Tora0615/WildlifeObservationDevice/feature tests/testModules/INMP_with_SD_with_custom_library_clean/INMP_with_SD_with_custom_library_clean.ino

// SD
#include <SPI.h>
#include "SdFat.h"
#include "sdios.h"
#define SPI_SPEED SD_SCK_MHZ(15)
#define CHIP_SELECT 5

// SD_FAT_TYPE 3 (FAT16/FAT32 and exFAT)
SdFs sd;


void SDInit(){
  if (!sd.begin(CHIP_SELECT, SPI_SPEED)) {
    Serial.println("SD card init error");
    while(1){
      delay(1000);
    }
  }
}



// void recordAndWrite(char* filename, int recordSeconds, int SAMPLE_RATE, int DATA_BIT, CHANNEL_STEREO){




// }



#include "MEMS_INMP441.h"

// #define SAMPLE_RATE     (38000)
// #define DATA_BIT        (16)

// Left : 0 / Right : 1 / stereo : 2
#define CHANNEL_LEFT     (0)
#define CHANNEL_RIGHT    (1)
#define CHANNEL_STEREO   (2)

INMP441 microphone(I2S_SCK_IO, I2S_WS_IO, I2S_DI_IO);
bool isRecording = false;



#define RECORD_TIME_DEBUG
// #define PERCENTAGE_DEBUG
#define INMP_COMMON_DEBUG


// #ifdef RECORD_TIME_DEBUG
//   int duration = 0;
//   int I2s_duration = 0;
//   int writeFile_duration = 0;
//   unsigned long busyWait_duration = 0;
// #endif


void recordWithDualChannel(int recordSeconds, char *filenameWithPath, float gain_ratio){
  if(!isRecording){
    // flag switch
    isRecording = !isRecording; 

    /*--- setting part ---*/
    // record setting 
    const uint16_t SAMPLE_RATE = 38000;
    const uint8_t  DATA_BIT = 16;
    const uint8_t  CHANNEL = CHANNEL_STEREO;
    float volume_gain = 64 * gain_ratio;  // 32 ~ 128 best
    const int numOfData = 512; // size of each collection
    byte header[44];  
    byte dataBuffer[numOfData];
    // SD setting 
    FsFile soundFile;


    /*--- execute part ---*/
    // remove old file 
    if (sd.exists(filenameWithPath)){
      sd.remove(filenameWithPath);
    }
    // create a new file 
    if (!soundFile.open(filenameWithPath, O_WRONLY | O_CREAT )) {     // open need char array, not string. So use c_str to convert
      Serial.println(" --> open file failed");
    }

    while(microphone.begin(SAMPLE_RATE, DATA_BIT, CHANNEL) != 0){
      Serial.println(" I2S init failed");
    }
    Serial.println("I2S init success");
    microphone.createWavHeader(header, recordSeconds, SAMPLE_RATE, DATA_BIT, CHANNEL);
    soundFile.write(header, 44);



    Serial.println("start");
    #ifdef RECORD_TIME_DEBUG
      int duration = millis();
      int I2s_duration = 0;
      int writeFile_duration = 0;
      unsigned long busyWait_duration = 0;
    #endif
    #ifdef PERCENTAGE_DEBUG
      float tempJ = 0;
    #endif


    int wavDataSize = recordSeconds * microphone.bytePerSecond; 
    int loopCount = wavDataSize / numOfData;
    int busy_wait_fix_factor = 4;
    unsigned long intervalTotalLen = recordSeconds * 1000.0 * 1000.0 / loopCount;
    #ifdef RECORD_TIME_DEBUG
      Serial.print("interval of each task (sec) : ");
      Serial.println(intervalTotalLen/1000000.0, 8);
      Serial.println("loopCount : " + String(loopCount));
    #endif
    for (int j = 0; j < loopCount; ++j) {
      // print process percentage 
      #ifdef PERCENTAGE_DEBUG
        if( ((j - tempJ)/(loopCount))*100.0 > 5) {
          Serial.println( ((float)j/(loopCount)) *100 );
          tempJ = j;
        }
      #endif

      // for busy wait
      unsigned long busy_wait_intervalTimer = micros(); 

      // read a size
      #ifdef RECORD_TIME_DEBUG
        int tempreadtime = millis();
      #endif
      microphone.read(dataBuffer, numOfData);
      #ifdef RECORD_TIME_DEBUG
        I2s_duration += millis() - tempreadtime;
      #endif

      // clean noise of not use side
      // DualChannel no need

      // let it louder of this size
      microphone.louder(dataBuffer, numOfData, volume_gain);

      // write this size
      #ifdef RECORD_TIME_DEBUG
        int tempwritefiletime = millis();
      #endif
      soundFile.write((uint8_t*)dataBuffer, numOfData);
      #ifdef RECORD_TIME_DEBUG
        writeFile_duration += millis() - tempwritefiletime;
      #endif

      // busy wait
      #ifdef RECORD_TIME_DEBUG
        int busyWaitTime = micros();
      #endif
      while (micros() - busy_wait_intervalTimer < intervalTotalLen && j % busy_wait_fix_factor == 0) {}
      #ifdef RECORD_TIME_DEBUG
        busyWait_duration += micros() - busyWaitTime;
      #endif
    }
    soundFile.close();
    microphone.end();
    #ifdef INMP_COMMON_DEBUG
      Serial.println("finish");
    #endif

    #ifdef RECORD_TIME_DEBUG
      Serial.println("use time : " + String ((millis() - duration)/1000.0, 4));
      Serial.println("I2s_duration : " + String (I2s_duration/1000.0, 4));
      Serial.println("writeFile_duration : " + String (writeFile_duration/1000.0, 4));
      Serial.println("busyWait_duration : " + String (busyWait_duration/1000000.0, 4));
    #endif

    // flag switch
    isRecording = !isRecording; 
  }
}


void recordWithMonoChannel(int recordSeconds, char *filenameWithPath, float gain_ratio, uint8_t CHANNEL){
  if(!isRecording){
    // flag switch
    isRecording = !isRecording; 

    /*--- setting part ---*/
    const uint16_t SAMPLE_RATE = 44100;
    const uint8_t  DATA_BIT = 16;
    float volume_gain = 64 * gain_ratio;  // 32 ~ 128 best
    const int numOfData = 512; // size of each collection
    byte header[44];  
    byte dataBuffer[numOfData];
    // SD setting 
    FsFile soundFile;

    /*--- execute part ---*/
    // remove old file 
    if (sd.exists(filenameWithPath)){
      sd.remove(filenameWithPath);
    }
    // create a new file 
    if (!soundFile.open(filenameWithPath, O_WRONLY | O_CREAT )) {     // open need char array, not string. So use c_str to convert
      Serial.println(" --> open file failed");
    }

    while(microphone.begin(SAMPLE_RATE, DATA_BIT, CHANNEL) != 0){
      Serial.println(" I2S init failed");
    }
    Serial.println("I2S init success");
    microphone.createWavHeader(header, recordSeconds, SAMPLE_RATE, DATA_BIT, CHANNEL);
    soundFile.write(header, 44);



    Serial.println("start");
    #ifdef RECORD_TIME_DEBUG
      int duration = millis();
      int I2s_duration = 0;
      int writeFile_duration = 0;
      unsigned long busyWait_duration = 0;
    #endif
    #ifdef PERCENTAGE_DEBUG
      float tempJ = 0;
    #endif


    int wavDataSize = recordSeconds * microphone.bytePerSecond; 
    int loopCount = wavDataSize / numOfData;
    int busy_wait_fix_factor = 1;
    unsigned long intervalTotalLen = recordSeconds * 1000.0 * 1000.0 / loopCount;
    #ifdef RECORD_TIME_DEBUG
      Serial.print("interval of each task (sec) : ");
      Serial.println(intervalTotalLen/1000000.0, 8);
      Serial.println("loopCount : " + String(loopCount));
    #endif
    for (int j = 0; j < loopCount; ++j) {
      // print process percentage 
      #ifdef PERCENTAGE_DEBUG
        if( ((j - tempJ)/(loopCount))*100.0 > 5) {
          Serial.println( ((float)j/(loopCount)) *100 );
          tempJ = j;
        }
      #endif

      // for busy wait
      unsigned long busy_wait_intervalTimer = micros(); 

      // read a size
      #ifdef RECORD_TIME_DEBUG
        int tempreadtime = millis();
      #endif
      microphone.read(dataBuffer, numOfData);
      #ifdef RECORD_TIME_DEBUG
        I2s_duration += millis() - tempreadtime;
      #endif

      // clean noise of not use side
      // TODO

      // let it louder of this size
      microphone.louder(dataBuffer, numOfData, volume_gain);

      // write this size
      #ifdef RECORD_TIME_DEBUG
        int tempwritefiletime = millis();
      #endif
      soundFile.write((uint8_t*)dataBuffer, numOfData);
      #ifdef RECORD_TIME_DEBUG
        writeFile_duration += millis() - tempwritefiletime;
      #endif

      // busy wait
      #ifdef RECORD_TIME_DEBUG
        int busyWaitTime = micros();
      #endif
      while (micros() - busy_wait_intervalTimer < intervalTotalLen && j % busy_wait_fix_factor == 0) {}
      #ifdef RECORD_TIME_DEBUG
        busyWait_duration += micros() - busyWaitTime;
      #endif
    }
    soundFile.close();
    microphone.end();
    #ifdef INMP_COMMON_DEBUG
      Serial.println("finish");
    #endif

    #ifdef RECORD_TIME_DEBUG
      Serial.println("use time : " + String ((millis() - duration)/1000.0, 4));
      Serial.println("I2s_duration : " + String (I2s_duration/1000.0, 4));
      Serial.println("writeFile_duration : " + String (writeFile_duration/1000.0, 4));
      Serial.println("busyWait_duration : " + String (busyWait_duration/1000000.0, 4));
    #endif

    // flag switch
    isRecording = !isRecording; 
  }
}



void setup(){
  Serial.begin(115200);
  SDInit();

  

  // Serial.println("Left");
  // delay(1000);
  // recordWithMonoChannel(10, "/10secLeft.wav", 1, CHANNEL_LEFT);

  // Serial.println("Right");
  // delay(1000);
  // recordWithMonoChannel(10, "/10secRight.wav", 1, CHANNEL_RIGHT);

  Serial.println("Dual");
  delay(1000);
  recordWithDualChannel(30, "/30secDual.wav", 1);

  // Serial.println("Dual_2X");
  // delay(1000);
  // recordWithDualChannel(10, "/10secDual2X.wav", 2);

  // Serial.println("Dual_05X");
  // delay(1000);
  // recordWithDualChannel(10, "/10secDual05X.wav", 0.5);
}


void loop(){



}
