Tora0615/WildlifeObservationDevice/(commit log)

2023-09-03 feat : battery part done
2023-09-03 fix : battery percentage error / feat : add kalman filter to reduce analog pulse
    [battery.h]
2023-09-04 fix : cross day time refresh bug
    [rtc_timer.h, utills.h, wildlife_observation.ino]
2023-09-04 doc : add wiring daigram and program flow chart
2023-09-10 doc : update wiring diagram
2023-09-11 feat : add DHT code, update pin define
2023-09-14 doc : updata wiring
2023-09-19 update current
2023-09-19 feat : add DHT22, RTC, DS18B20 power control
2023-09-22 fix : task time int error
    [testPointer.ino]
2023-09-23 feat : LED improve
2023-09-24 feat : upload current
2023-09-24 feat : done most system log and sensor data log
2023-09-25 feat : add reset and wakeup log check
    [myScheduler.h, sd_operation.h, taskFileReader.h, utills.h, wildlife_observation.ino]
2023-09-25 fix : DHT nan value, feat : add INMP skip condition if is recording
    [myDHT.h, myINMP441.h, myScheduler.h, sd_operation.h, setting.h, utills.h]
2023-09-25 feat : apply boot and reset condition log
    [utills.h, wildlife_observation.ino]
2023-09-25 upload current
2023-09-26 fix : sd speed error, feat : log write task called time
    [INMP_with_SD_with_seperate_task.ino, myINMP441.h, myScheduler.h, sd_operation.h, setting.h, taskFileReader.h, wildlife_observation.ino]
2023-09-27 fix : feed dog problem
    [myScheduler.h, utills.h]
2023-10-06 fix : day change problem (not test yet), DS18B20 can't be read after sleep finished, core panic
    DS18B20 can't be read after sleep finished : caused by go to sleep while reading
    Core panic : DS18B20 read nothing then the function return
    [myScheduler.h, setting.h, utills.h]
2023-10-06 fix : data record part's time order is strenge, doc : disable some debug print
    [myScheduler.h, setting.h]
2023-10-07 fix : day change issue, sys log issue 1. fix sleep toooo long -- array out of range - now sleep have two part : before and after day change part 2. fix task index not rewind 3. fix next task time not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
    [myScheduler.h, rtc_timer.h, sd_operation.h, taskFileReader.h, wildlife_observation.ino]
2023-10-08 doc : reset time to the real one
    [ds3231_set_time.ino, rtc_timer.h, setting.h, wildlife_observation.ino]
2023-10-09 fix : add feed dog function
    [myINMP441.h]
2023-10-09 fix : battery minimum voltage, can't go sleep after record, watch dog triggered
    [battery.h, myINMP441.h, myScheduler.h, utills.h]
2023-10-09 fix : evaluation relative code
    [myScheduler.h, rtc_timer.h, utills.h]
2023-10-11 fix : rtc timer's i2c bus pullup cause pmos leak power
    [rtc_timer.h]
2023-10-11 fix : DHT pullup leak power, feat : mutex of DHT and DS18B20 power
    [myDHT.h, myDS18B20.h, myScheduler.h, setting.h]
2023-10-24 doc : update wiring
2023-10-24 fix : add evalution mode switch and close it
    [rtc_timer.h, setting.h, utills.h]
2023-11-16 Just save current progress
2023-11-17 Just upload current progress
2023-11-20 fix : can't sleep & init too slow
    [myScheduler.h, sd_operation.h, setting.h, wildlife_observation.ino]
2023-11-20 fix : panic of adjust rtc & some data show error
    [rtc_timer.h, sd_operation.h, setting.h, taskFileReader.h]
2023-11-20 fix : sound record task caused panic
    [myINMP441.h, myScheduler.h, taskFileReader.h, utills.h]
2023-11-22 fix : record time too long caused by RTOS delay in record loop
    [myINMP441.h, myScheduler.h, sd_operation.h]
2023-11-22 fix : record time not correct
    [myScheduler.h]
2023-11-22 feat : change RTC time and function to correct one / doc : delete old file
    [rtc_timer.h, sd_operation.h, setting.h]
2023-12-08 fix : the sleep error caused by rtc is slower than local time when cross day
    [myScheduler.h, rtc_timer.h, sd_operation.h]
2023-12-08 fix : adjust sleep time back to N instead of N+10 sec
    [myScheduler.h]
2023-12-14 doc : change ESP pin mark
2023-12-28 feat : add alive led and add auto reboot when open file failed
    [myScheduler.h, sd_operation.h, utills.h]
2024-01-25 feat : add a compile switch of battery filter and diasbled it
2024-01-25 feat : change the exec order of print msg and vTaskDelay in sleep loop
2024-01-25 feat : delete infinity loop when open file failed in write log function
    [sd_operation.h]
2024-01-25 feat : delete parse task print soo many lines
2024-01-25 fix : sleep in deep sleep configure
    [myScheduler.h]
2024-03-27 fix: job order mess by direct save work index into rtc memory
    [setting.h, taskFileReader.h, wildlife_observation.ino]
2024-04-23 feat : change the pin define
2024-04-23 feat : collect init led together and redefine it's meaning
2024-04-23 feat : add running state LED and RTOS task
2024-05-02 feat : integrate OTA into main code of the device
2024-05-02 fix : blue and green LED error - GPIO input only / feat : limit no sd retry by deep sleep instead of restart
    [sd_operation.h, setting.h, utills.h]
2024-05-03 fix : new module can't get the I2C RTC device
    [rtc_timer.h]
2024-05-10 feat : change the task prioiry of LEDs / doc : init print change
2024-05-12 fix : DHT & DS18 in new board don't have value
    * cause : power up time not enough
    [myDHT.h, myScheduler.h, sd_operation.h, setting.h, softAp.h, wildlife_observation.ino]
2024-06-25 feat : done the scheduler, task/index(min) converter / refactor : name of findTheMatchedTaskIndex()
    * By add tasks in RTC_DATA_ATTR array, which sized 1440
    * uint8NumToCharArr(), uint8ToString()
    * Define the new structure of tasks
    * readTaskIndex_moveToNext() & readSettingIndex_moveToNext()
    * Update the index moving of task
    * Now it can auto re-zero and move to the index have task
    * scheduler :
    * re-write all flow to match the new data structure
    * TODO : Sensor data print format
2024-06-26 feat : intergrate the RTC update into the main code / fix : read file error caused by code name incorrect / doc : issue list
    [setting.h, softAp.h, taskFileReader.h, updateServer.h, utills.h]
2024-06-27 fix : rtc time shown error / feat : lang setting in html, update check of the format of time
    * rtc time shown error in web and caused connection lost
    * called before init yet
    * others :
    * zh show strange in html -- add UTF-8 seeting in html
    [setting.h, softAp.h, updateServer.h, wildlife_observation.ino]
2024-06-27 fix : rtc not work at pcb_v1, forgot to open the switch
    [myDHT.h, myDS18B20.h, myScheduler.h, setting.h, utills.h]
2024-06-28 fix : cross day error / doc : debug print
    * When meet day change, time change but the index still at the end of array
    --> will run forever
    --> cause forget to use the flag in findTheIndexOfCurrentTime
    --> index change often at the end of task calling
    [myScheduler.h, rtc_timer.h, taskFileReader.h]
2024-06-28 fix : task at 00:00 skiped
    * in isFirstBoot, findTheIndexOfCurrentTime give a correct to be run task
    ----> So, readTaskIndex_moveToNext() will cause index add one more
    [wildlife_observation.ino]
2024-07-02 fix : panic of DMA malloc error by adjust RTOS stack size
    [myScheduler.h]
2024-07-02 doc : adjust status print out format, open battery debug info
2024-07-04 doc : print msg
2024-07-04 feat : adjust RTOS stack size and import GPIO driver for pull_up_disable
2024-08-16 feat : voltage status in web
2024-08-16 feat : disable brownout / fix : DS18B20 no data (caused by wifi)
    [softAp.h, wildlife_observation.ino]
2024-08-20 fix : DS18B20 not work on pcb_v1
    * ONE_WIRE_BUS was used in softAP, we need to configure it's pin mode again
    [myDS18B20.h, wildlife_observation.ino]
2024-08-20 fix : system log error path
    [myScheduler.h]
